vktrbot/R.O.V.R/roboarm/Roboarm 3D parts/Base of the robot arm.3MF

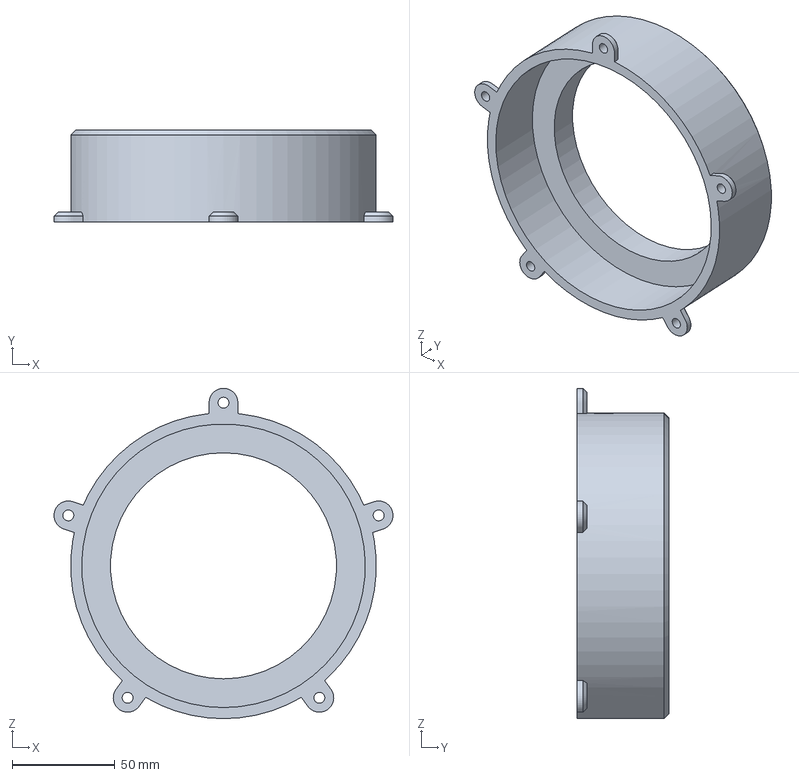
[picture p1: CAD file, 2026-04-10]
roboarm/Roboarm 3D parts/Base of the robot arm.3MF
165.0 x 45.0 x 160.8 mm
