vktrbot/R.O.V.R/roboarm/Roboarm 3D parts/Third arm part.3MF

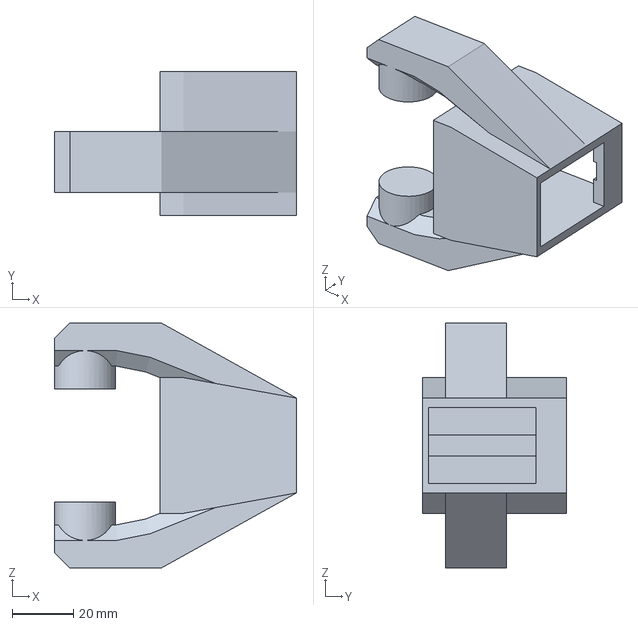
[picture p2: CAD file, 2026-04-10]
roboarm/Roboarm 3D parts/Third arm part.3MF
79.1 x 47.0 x 80.0 mm
