vktrbot/R.O.V.R/roboarm/Roboarm 3D parts/Servo model.3MF

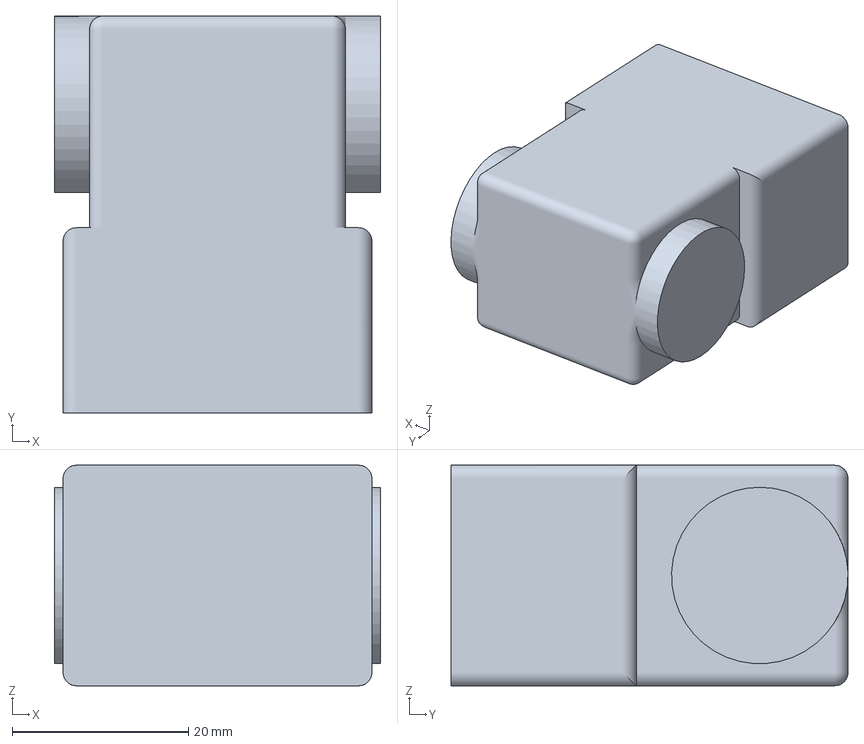
[picture p4: CAD file, 2026-04-10]
roboarm/Roboarm 3D parts/Servo model.3MF
37.0 x 45.0 x 25.0 mm
