vktrbot/R.O.V.R/roboarm/Roboarm 3D parts/Bottom rotation plate on the robot arm.3MF

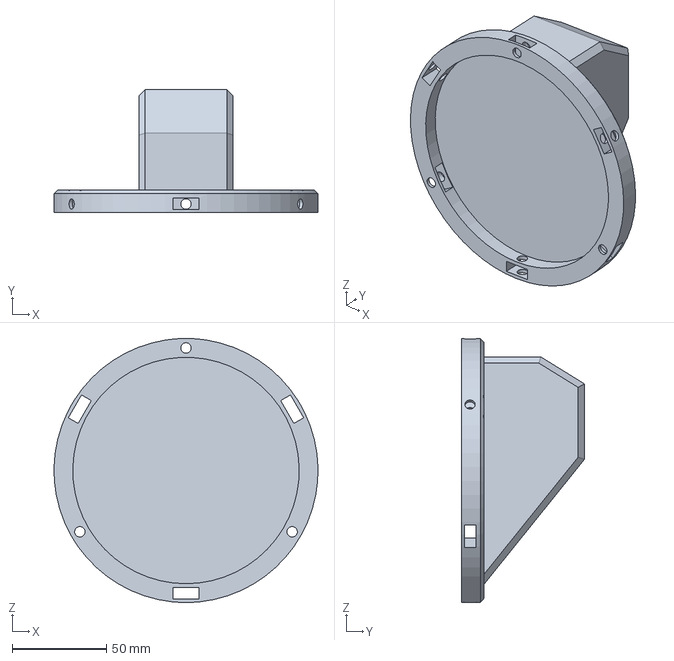
[picture p5: CAD file, 2026-04-10]
roboarm/Roboarm 3D parts/Bottom rotation plate on the robot arm.3MF
140.0 x 65.2 x 140.0 mm
