vktrbot/R.O.V.R/roboarm/Roboarm 3D parts/Robot gripper.3MF

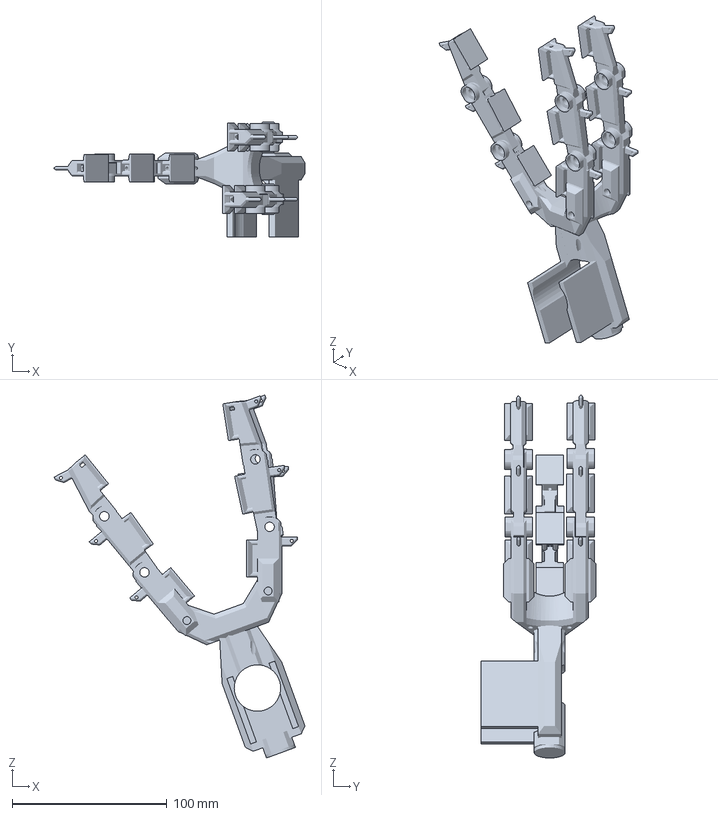
[picture p6: CAD file, 2026-04-10]
roboarm/Roboarm 3D parts/Robot gripper.3MF
162.2 x 74.5 x 234.7 mm
