vktrbot/R.O.V.R/roboarm/Roboarm 3D parts/Second arm part.3MF

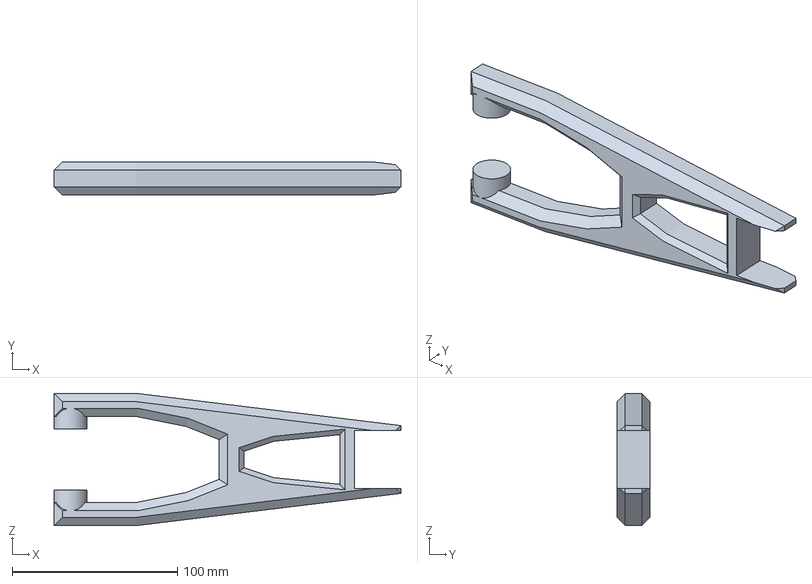
[picture p7: CAD file, 2026-04-10]
roboarm/Roboarm 3D parts/Second arm part.3MF
210.0 x 20.0 x 80.0 mm
