vktrbot/R.O.V.R/roboarm/Roboarm 3D parts/Assembled Robot Arm.SLDASM

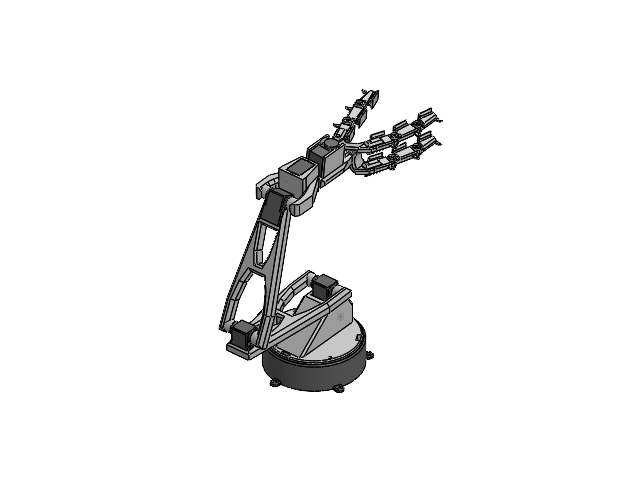
[picture p8: CAD file, 2026-04-10]
roboarm/Roboarm 3D parts/Assembled Robot Arm.SLDASM
Grunen på robotarmen
Bottenrotationsplatta på robotarmen
Servo modell x 5
Första arm delen
Andra arm delen
Robot tendor 1 (1) x 3
Robot tendor 1 (2) x 3
Robot tendor 1 (3) x 3
gripperhållaren
Nu tredje armdelen
