vktrbot/R.O.V.R/(list of files, cad)

Other CAD files:
roboarm/Roboarm model for IK/ROBOTARM BLENDER.blend
